jj21065/Stewart_Platform/Stewart_Plateform_CAD/第三組期末報告.pptx

## 史都華平台自動控制

第三組
N16054564 詹上緣
N16054530 林德祐

## 目錄

- 研究動機
- 問題與目標
- 研究方法與設計
- 結果與討論
- 結論

## 研究動機

Notes: 降低製程的複雜度
降低加熱器的功耗

## Slide 4

- 設計一

## 史都華平台

- 史都華平台為一六軸並聯式的運動平台，
  - 六個致動器控制位置
  - 由十二個萬向接頭與可動板及固定板所組成
  - 前後移動(Surge)、左右橫移(Sway)、升降起伏(Heave)、左右側傾(Roll)、前後翻滾(Pitch)、左右平擺(Yaw)等運動。

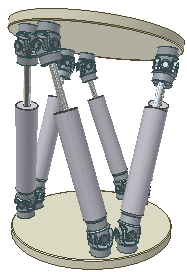
[picture p1: figure]

https://en.wikipedia.org/wiki/Stewart_platform

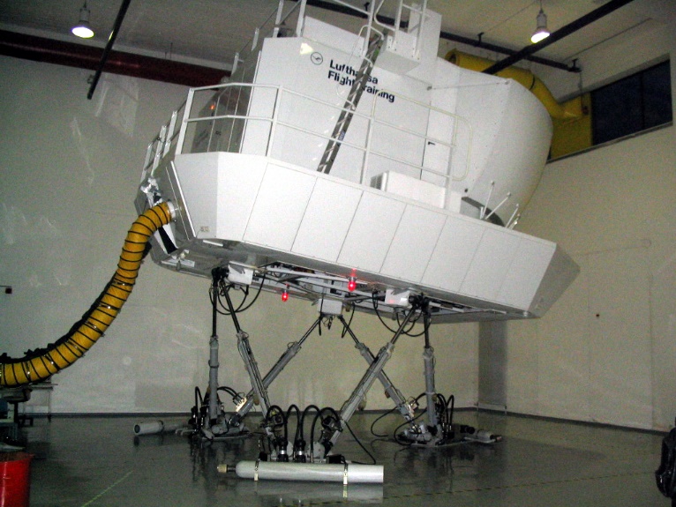
[picture p2: figure]

Flight simulation

## 轉換矩陣

- 定義TP為{P}座標系轉至{B}座標系之轉換矩陣
[, x, y, z, 1]B=TP[, x, y, z, 1]P , Tp= [R, TV0, 1]
R = R γ R β R α = [cosγ, −sinγ, 0sinγ, cosγ, 00, 0, 1][cosβ, 0, sinβ0, 1, 0−sinβ, 0, cosβ][1, 0, 00, cosα, -sinα0, sinα, cosα]
γ,β,α 為可平板與x,y,z三軸之夾角

## 可動平板姿態

- 可動平板上六的關節空間座標即可由轉換矩陣求得
Pi(i = 1~6)為可動平板關節空間座標
Bi 固定板之連接點之空間座標
BPi = Tv + R× PPi
Si = BPi - BBi ,
Li =|Si|

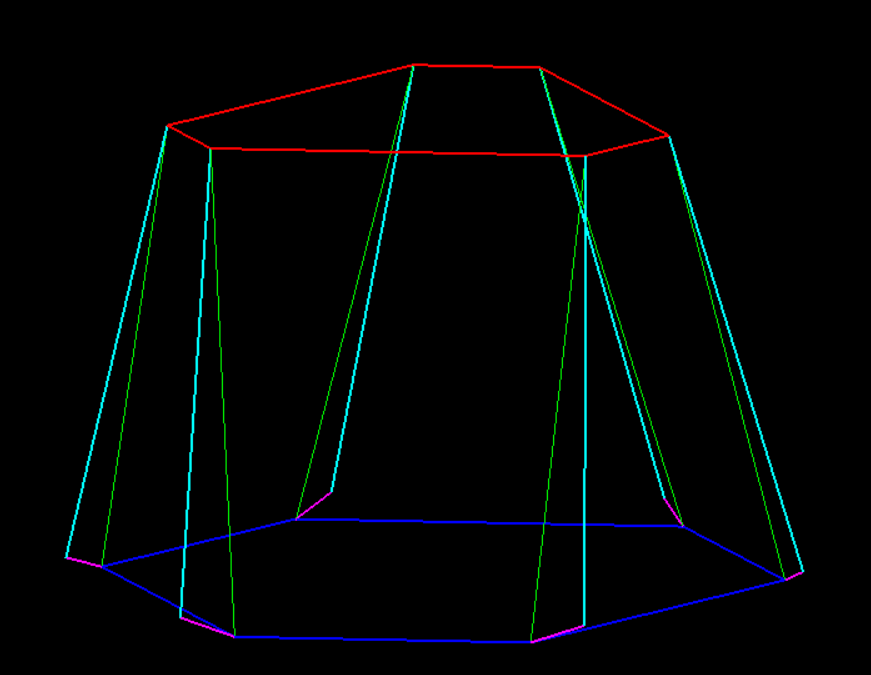
[picture p3: figure]

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
## 程式模擬

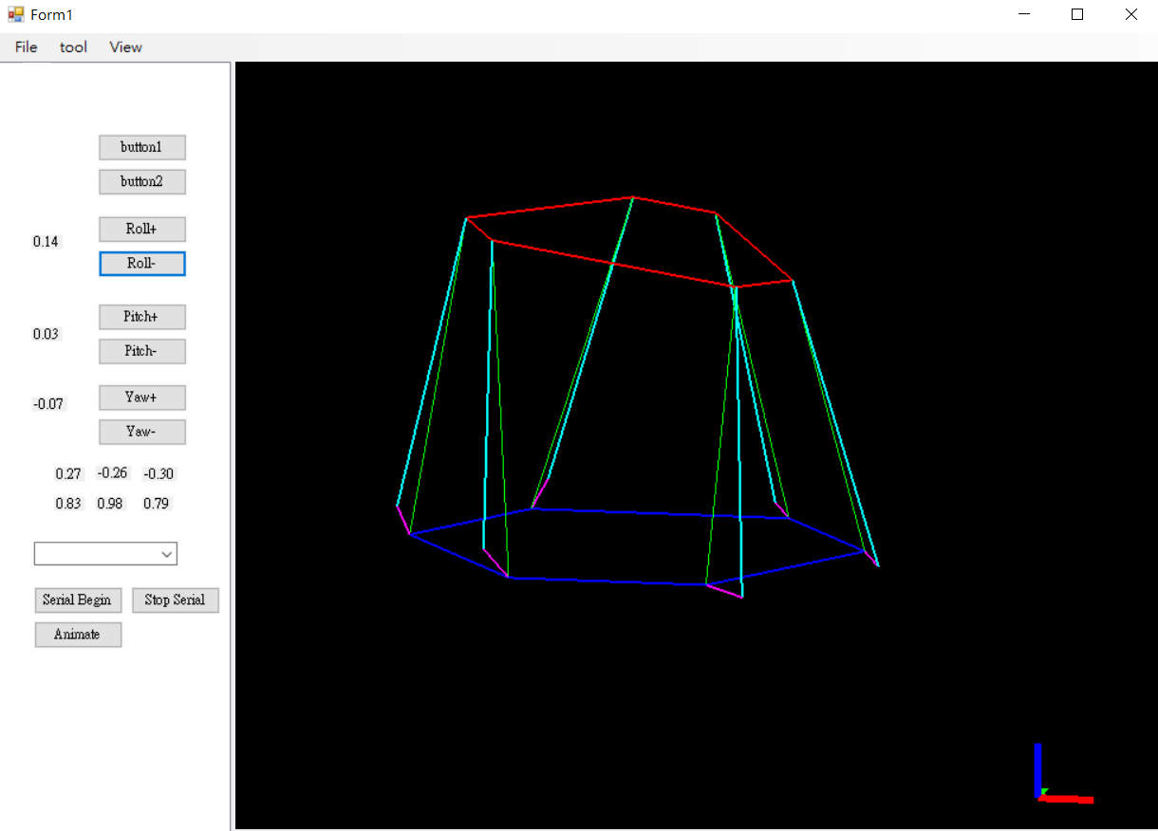
[picture p4: figure]

- 以Windows form開發
- 驗證數學模型正確
- 測試前後移動(Surge)、左右橫移(Sway)、升降起伏(Heave)、左右側傾(Roll)、前後翻滾(Pitch)、左右平擺(Yaw)等運動

## 機構設計

- 以六顆伺服馬達取代六個線性致動器
- 依照程式模擬的參數設定可動平板、固定板、連接桿尺寸

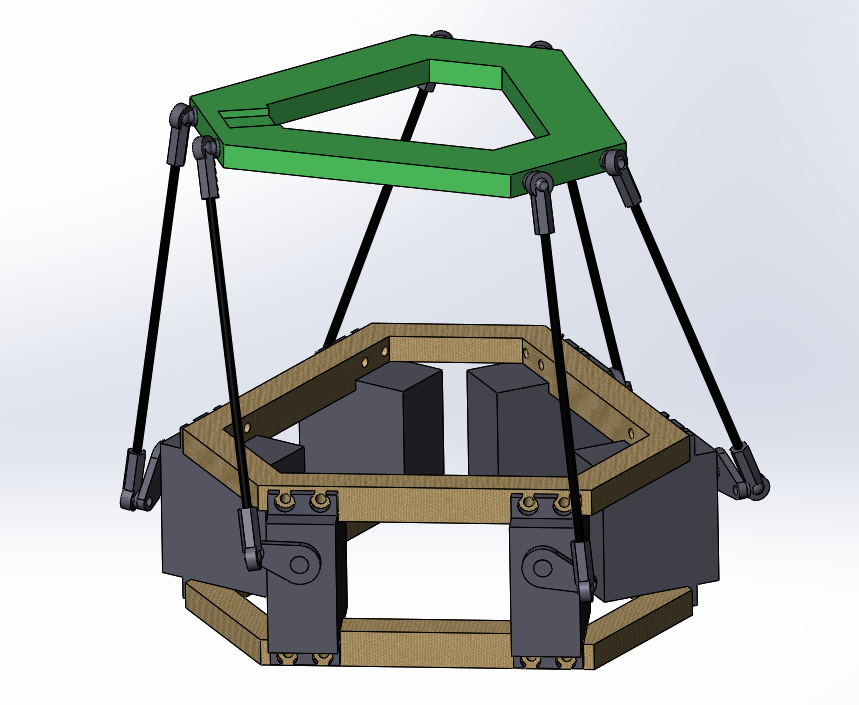
[picture p5: figure]

可動平板

## 伺服馬達(servo motor)

- 其組成包含直流馬達、減速齒輪、電位計、控制電路
- 輸入PWM訊號，內部電路依不同脈衝寬度控制馬達轉動至不同角度
- 內部控制電路以電位計電壓作為角度回饋
- 取得容易價格也較便宜

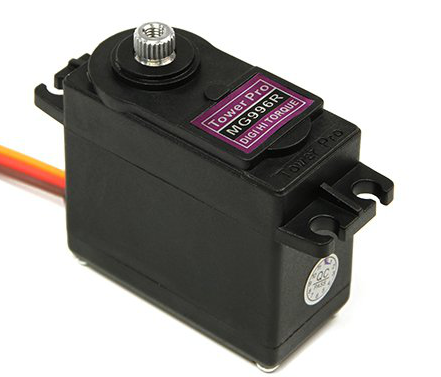
[picture p6: figure]
相關圖片

## 控制電路

- 將平台逆向運動計算編寫進Arduino單晶片，以PID控制
- PCA9685以I2C與Arduino溝通，控制6組馬達
- JY901輸出姿態角度，安裝在可動平板上，作為姿態回饋給Arduino姿態測量穩定度：0.01°

Arduino UNO

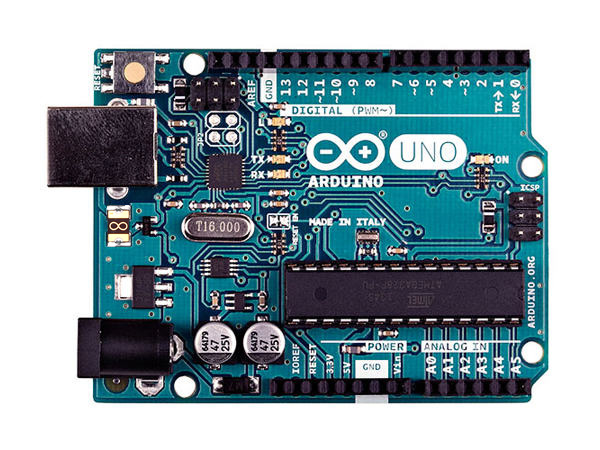
[picture p7: figure]
「Arduino UNO」的圖片搜尋結果

JY901

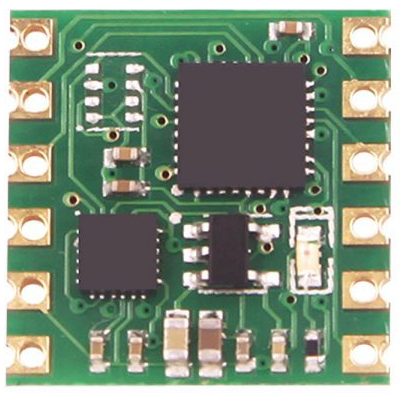
[picture p8: figure]
61gzqf5tbel-_sl1000_

PCA9685 PWM驅動板

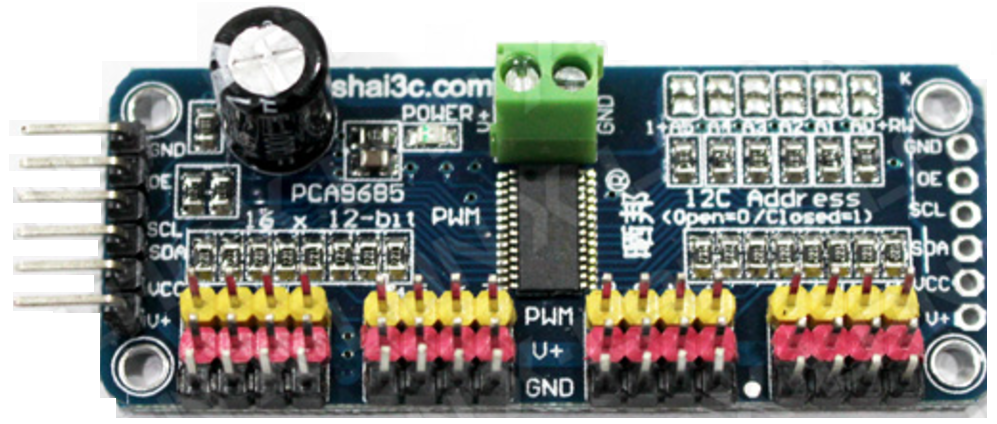
[picture p9: figure]

Notes: JY901內部包含卡爾曼濾波器

## 自動平衡

- 基本動作測試
- 以JY901姿態回饋，平台自動追隨目標角度

## Slide 13

## 結果與討論

## 結論

## Q&A
