jj21065/Stewart_Platform/Stewart_Plateform_CAD/史都華平台設計/史都華平台.SLDASM

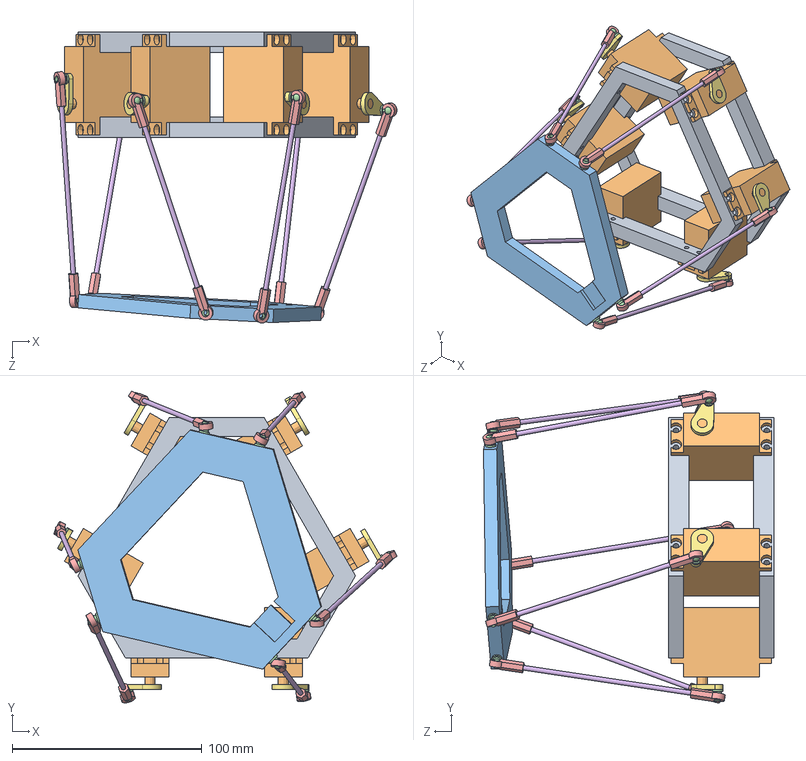
[picture p10: CAD file, 2018-02-09]
Stewart_Plateform_CAD/史都華平台設計/史都華平台.SLDASM
180.7 x 164.3 x 153.4 mm
底座 x 2
MG996伺服 x 6
平台
ball x 12
balljoint x 12
linkage x 6
arm x 6
