jj21065/Stewart_Platform/Stewart_Plateform_CAD/史都華平台設計/列印件/MG996馬達座.SLDPRT

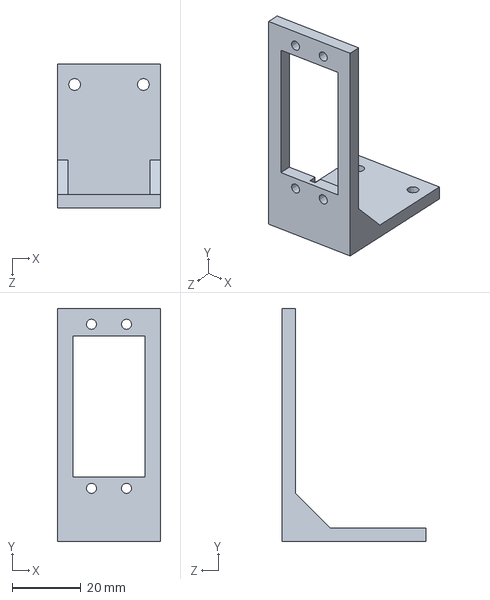
[picture p11: CAD file, 2018-02-09]
Stewart_Plateform_CAD/史都華平台設計/列印件/MG996馬達座.SLDPRT
30.0 x 67.9 x 42.0 mm
