jj21065/Stewart_Platform/Stewart_Plateform_CAD/史都華平台設計/加工件/底座.SLDPRT

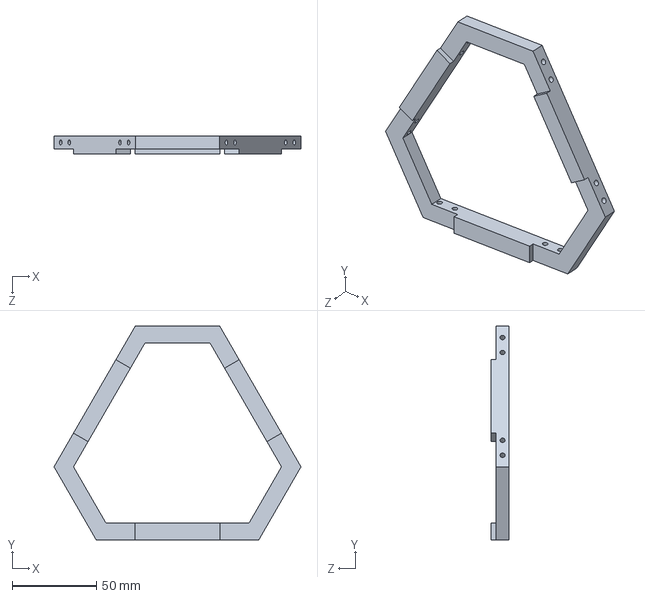
[picture p12: CAD file, 2018-02-09]
Stewart_Plateform_CAD/史都華平台設計/加工件/底座.SLDPRT
146.2 x 126.7 x 10.8 mm
