jj21065/Stewart_Platform/Stewart_Plateform_CAD/史都華平台設計/訂購件/arm.SLDPRT

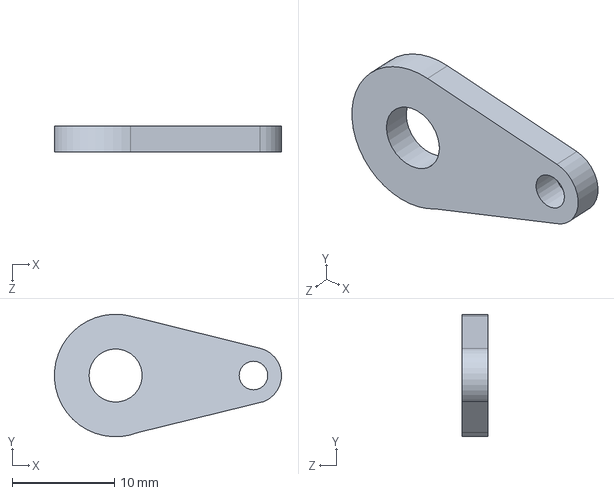
[picture p13: CAD file, 2018-02-09]
Stewart_Plateform_CAD/史都華平台設計/訂購件/arm.SLDPRT
22.2 x 12.0 x 2.50 mm
