jj21065/Stewart_Platform/Stewart_Plateform_CAD/史都華平台設計/加工件/平台.SLDPRT

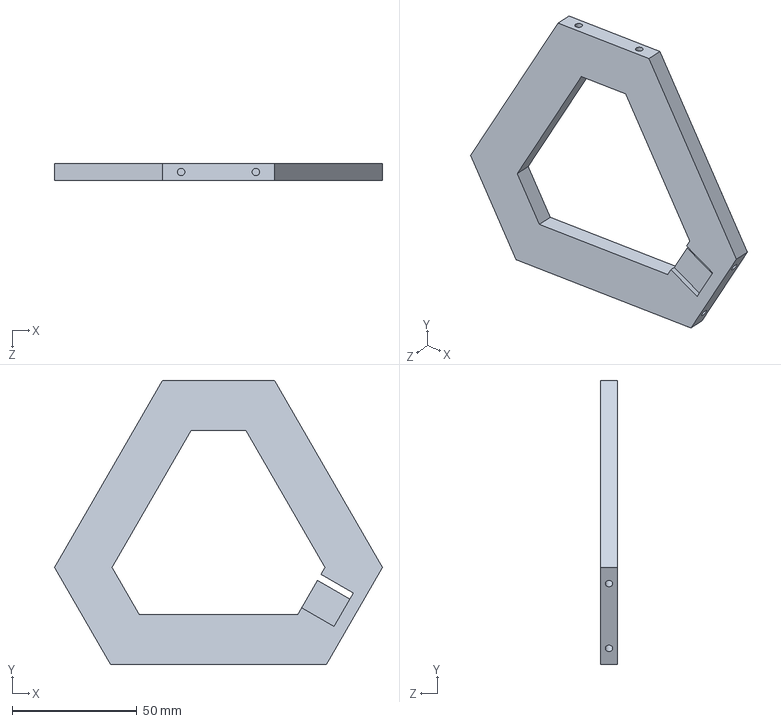
[picture p14: CAD file, 2018-02-09]
Stewart_Plateform_CAD/史都華平台設計/加工件/平台.SLDPRT
131.6 x 114.0 x 7.00 mm
