jj21065/Stewart_Platform/Stewart_Plateform_CAD/史都華平台設計/訂購件/MG996伺服.SLDPRT

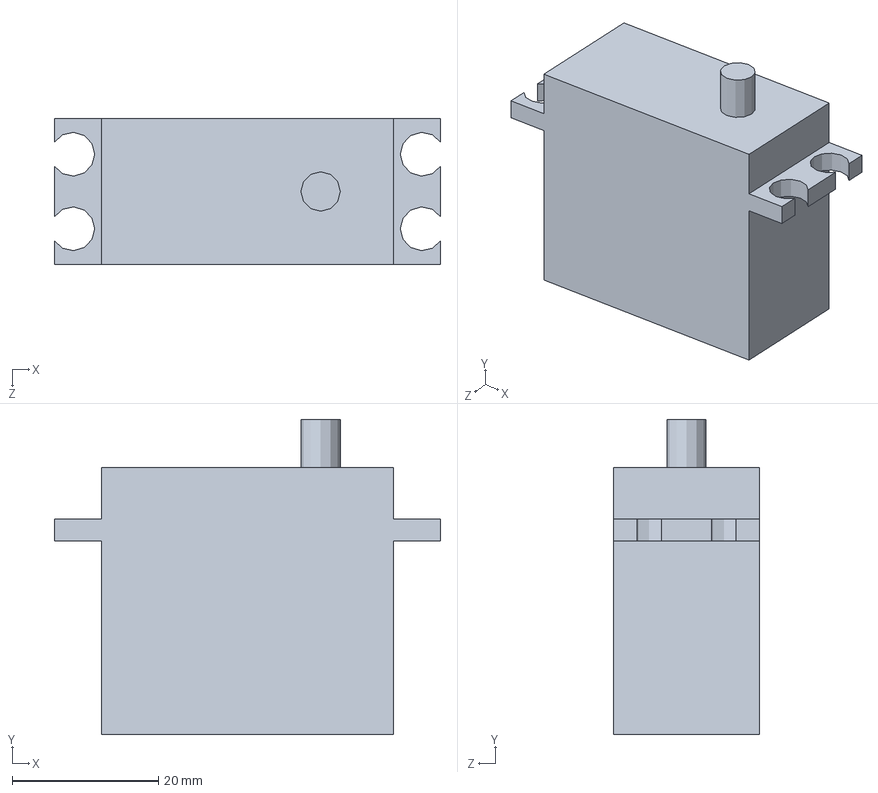
[picture p15: CAD file, 2018-02-09]
Stewart_Plateform_CAD/史都華平台設計/訂購件/MG996伺服.SLDPRT
52.8 x 43.1 x 20.0 mm
