jj21065/Stewart_Platform/Stewart_Plateform_CAD/史都華平台設計/訂購件/linkage.SLDPRT

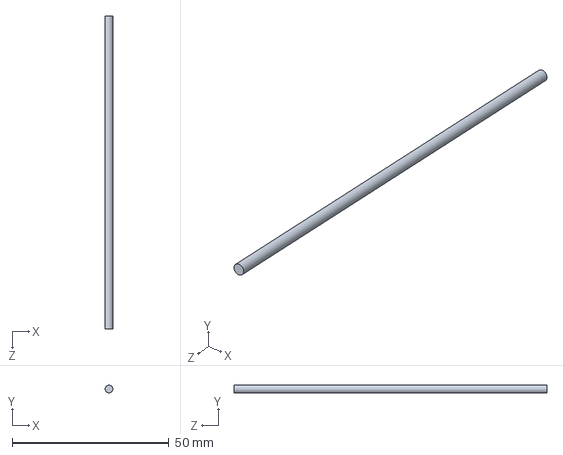
[picture p16: CAD file, 2018-02-09]
Stewart_Plateform_CAD/史都華平台設計/訂購件/linkage.SLDPRT
2.50 x 2.50 x 100.0 mm
