jj21065/Stewart_Platform/Stewart_Plateform_CAD/史都華平台設計/訂購件/MG995伺服.SLDPRT

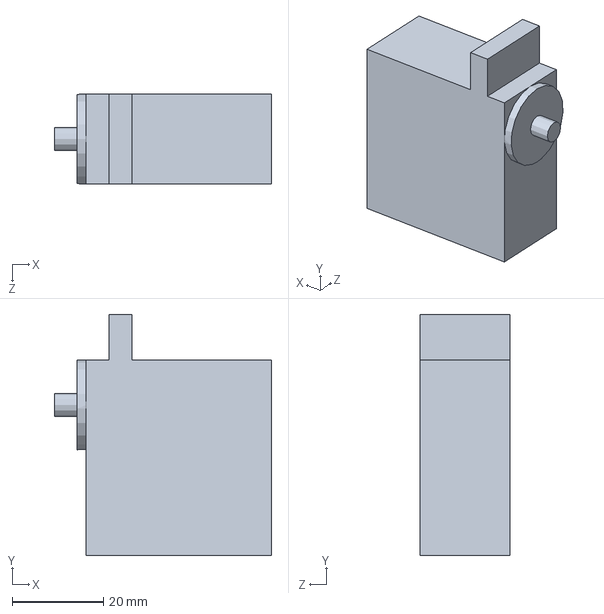
[picture p17: CAD file, 2018-02-09]
Stewart_Plateform_CAD/史都華平台設計/訂購件/MG995伺服.SLDPRT
47.7 x 52.9 x 19.7 mm
