jj21065/Stewart_Platform/Stewart_Plateform_CAD/史都華平台設計/訂購件/balljoint.SLDPRT

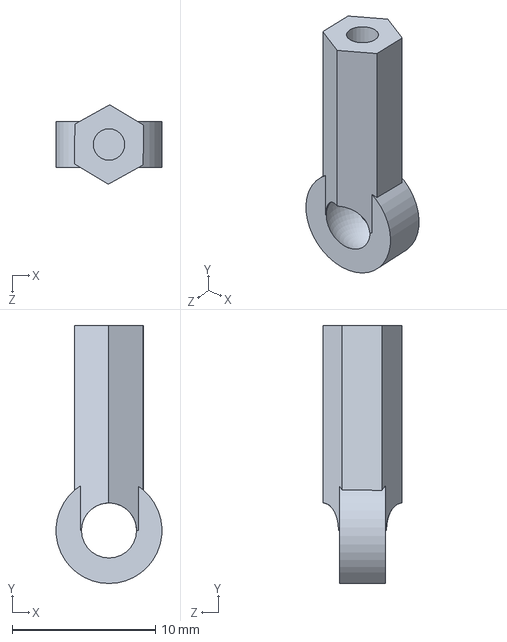
[picture p18: CAD file, 2018-02-09]
Stewart_Plateform_CAD/史都華平台設計/訂購件/balljoint.SLDPRT
7.39 x 18.0 x 5.54 mm
