jj21065/Stewart_Platform/Stewart_Plateform_CAD/史都華平台設計/訂購件/ball.SLDPRT

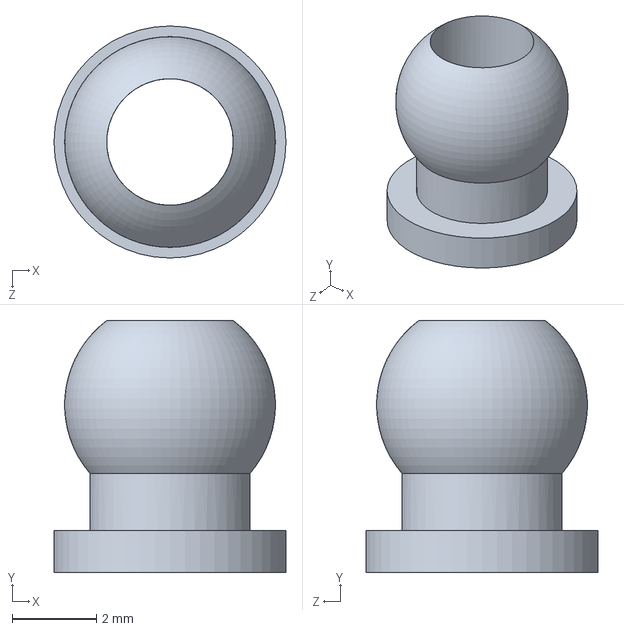
[picture p19: CAD file, 2018-02-09]
Stewart_Plateform_CAD/史都華平台設計/訂購件/ball.SLDPRT
5.50 x 5.98 x 5.50 mm
