jj21065/Stewart_Platform/(list of files, cad)

Other CAD files:
Stewart_Plateform_CAD/史都華平台設計/加工件/平台.STL
Stewart_Plateform_CAD/史都華平台設計/加工件/底座.STL
