jj21065/Stewart_Platform/myServo.h

class myServo
{
public:
	float thida_S;
	float arm_length;
	float connect_length;
	float angle;
	float angle_pre;
public:
	myServo()
	{
		arm_length = 16.0;
		connect_length = 111.0;
		angle = 0;
	}
};
